TadAtThayer/ECG/Docs/ECG.png

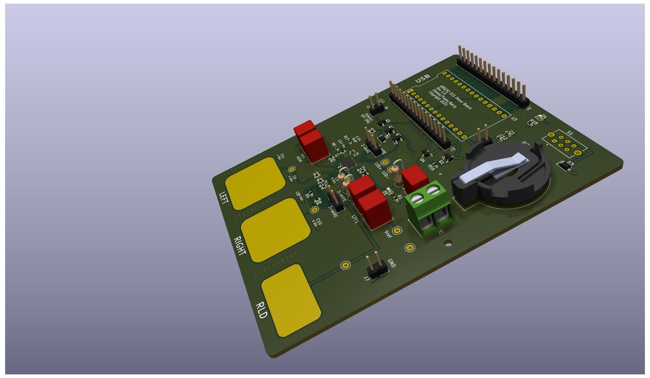
Docs/ECG.png
