TadAtThayer/ECG/README.md

# ECG

Prototype board for our online MENG program.

Utilizes an AD8232 Heart monitor AFE and has a supporting Arduino Nano 33 BLE.
