TadAtThayer/ECG/Docs/ECG_V1.0.pdf

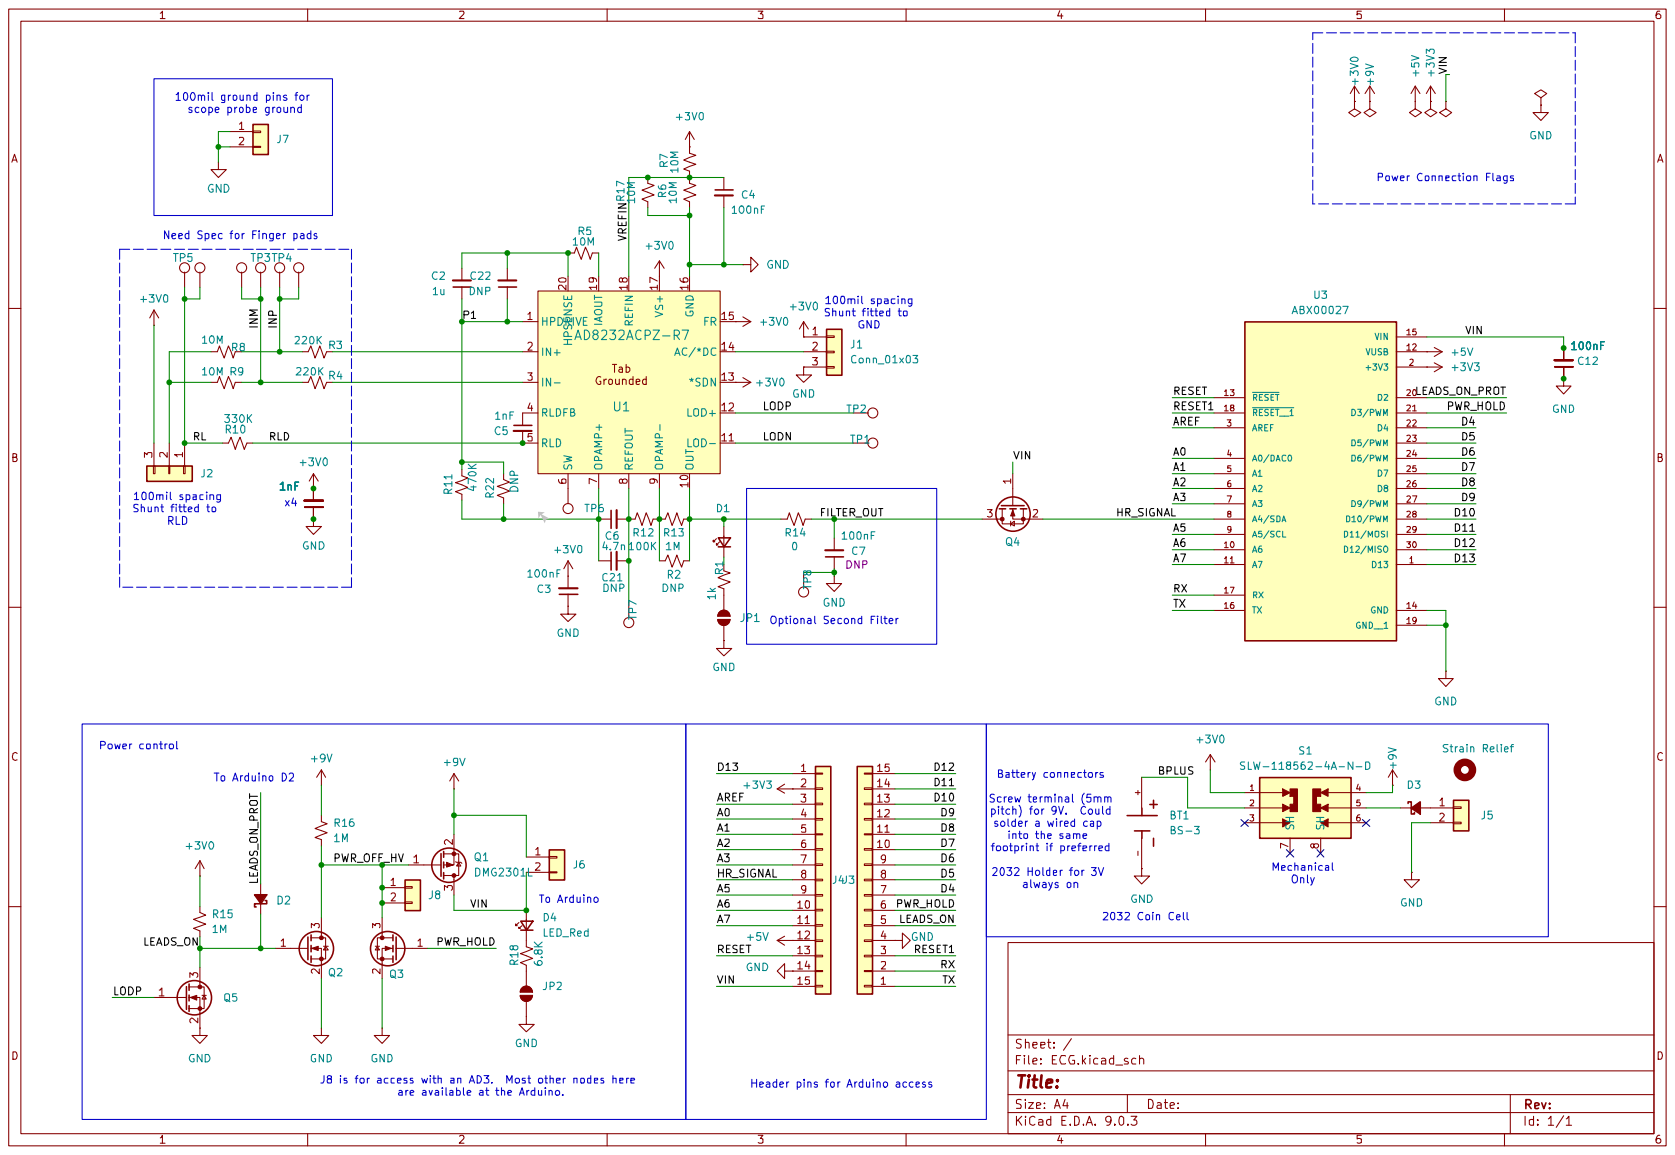
[picture p2: page 1]
