TadAtThayer/ECG/ECG/ECG.kicad_pcb

## KiCad design ECG/ECG.kicad_pcb (2026-07-17)

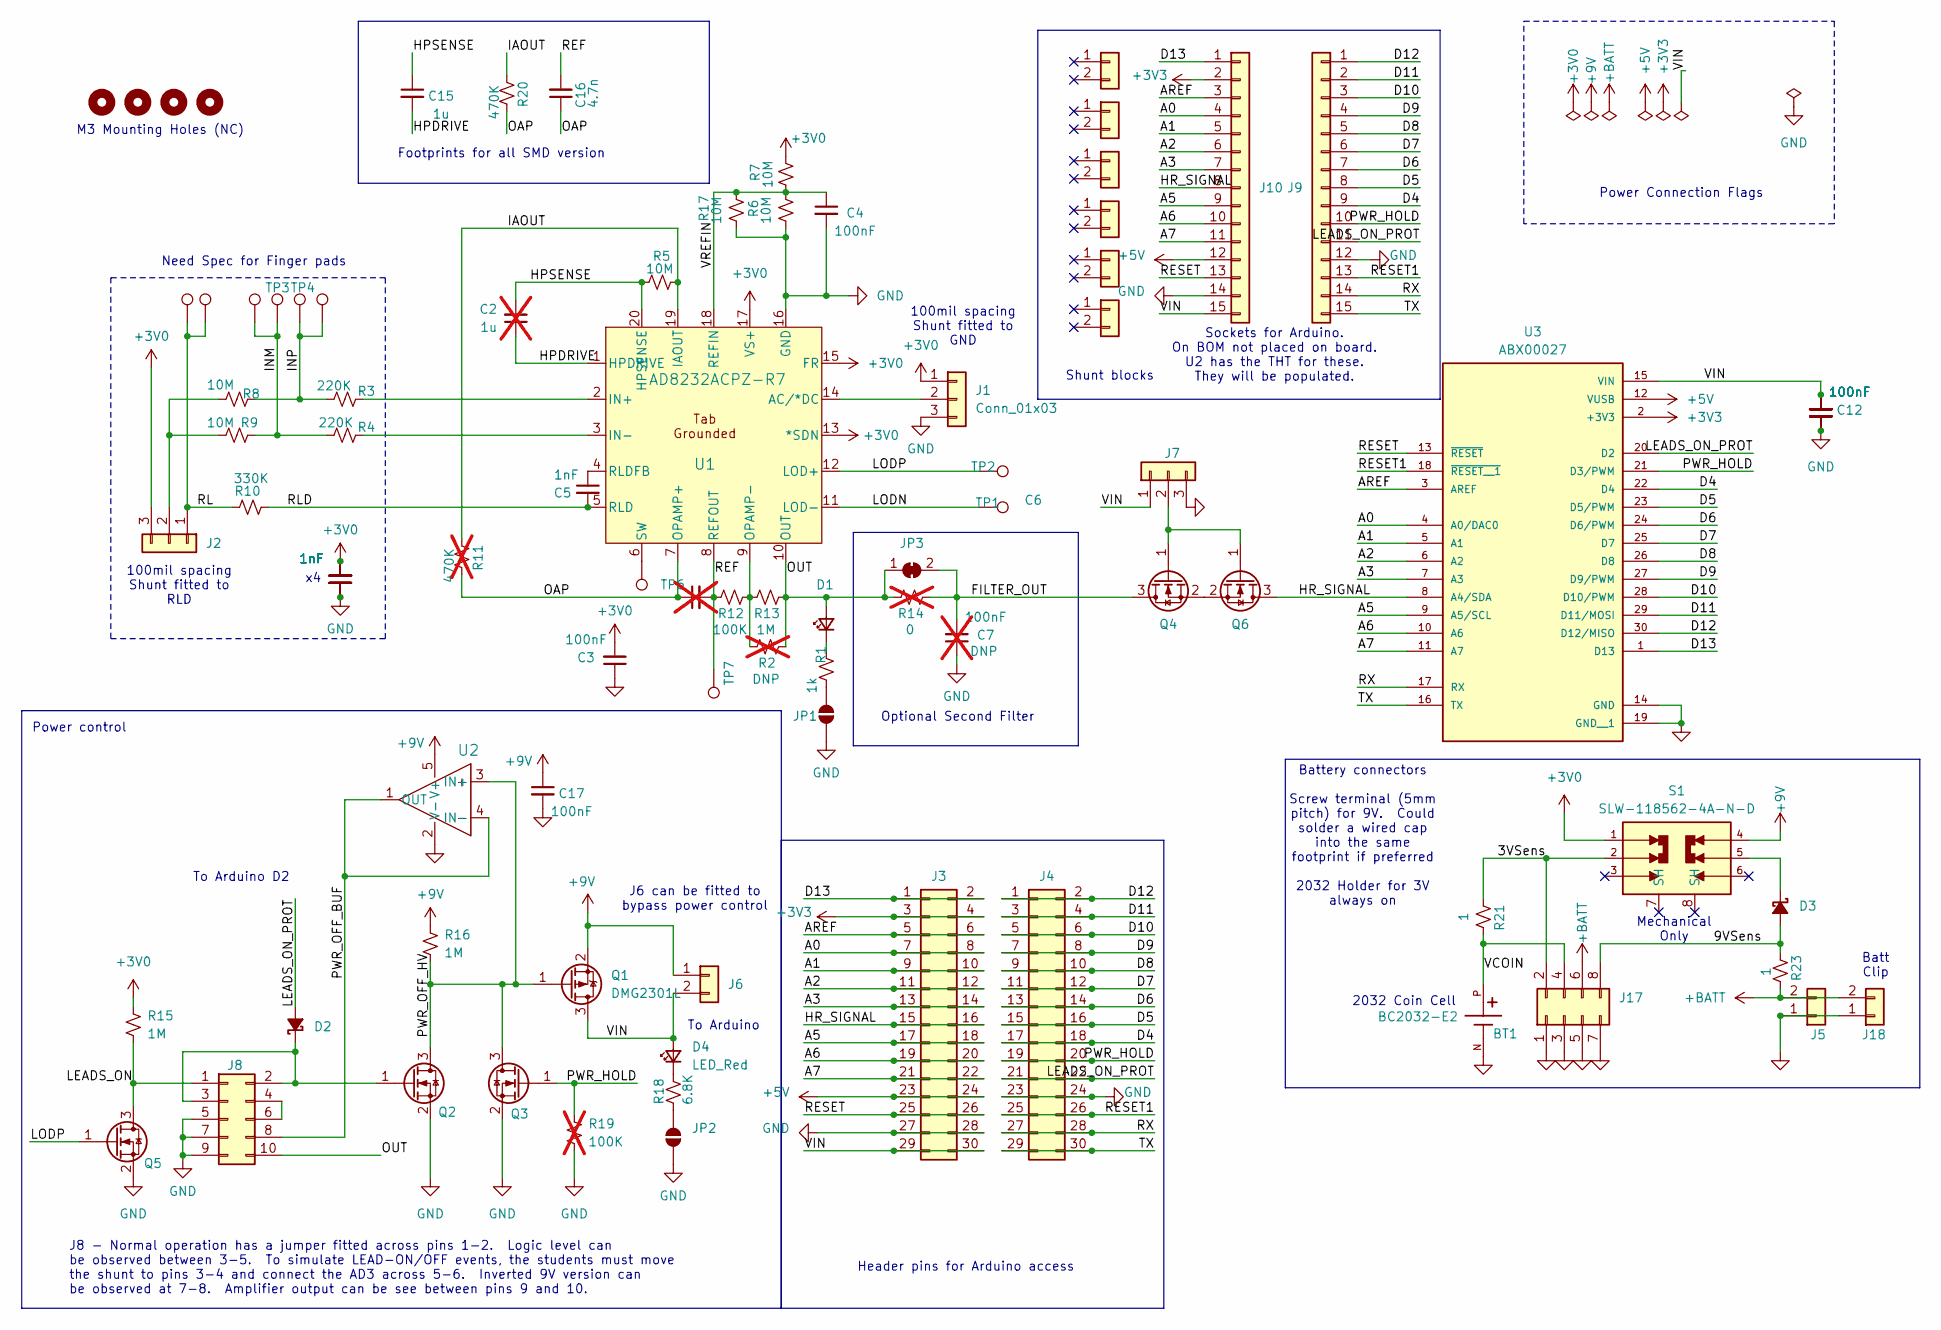
[picture p4: schematic ECG.kicad_sch]

Parts:
BT1: BC2032-E2; MPD_BC2032-E2; PARTREV D; DigikeyPN BC2032-E2-ND
C1, C3, C4, C12, C13, C14, C17: 100nF; C_0603_1608Metric; DigikeyPN 1276-1000-1-ND
C2: 1u; C_Rect_L7.2mm_W5.5mm_P5.00mm_FKS2_FKP2_MKS2_MKP2; DigikeyPN 399-5455-1-ND; not fitted
C5, C8, C9, C10, C11: 1nF; C_0603_1608Metric; DigikeyPN 1276-1018-1-ND
C6: 4.7n; C_Rect_L7.2mm_W5.5mm_P5.00mm_FKS2_FKP2_MKS2_MKP2; DigikeyPN 399-5905-ND; not fitted
C7: 100nF; C_Rect_L7.2mm_W5.5mm_P5.00mm_FKS2_FKP2_MKS2_MKP2; not fitted
C15: 1u; C_0603_1608Metric; DigikeyPN 311-2082-1-ND
C16: 4.7n; C_0603_1608Metric; Manufacturer_PN CL10B472KB8NNNC; DigikeyPN 1276-1098-1-ND
D1, D4: LED_Red; LED_0603_1608Metric; MPN 150060RS75000; DigikeyPN 732-4978-2-ND
D2, D3: D_SOD-123; DigikeyPN SM5817PL-TPMSCT-ND
H2, H3, H4, H5: MountingHole; MountingHole_3.2mm_M3
J1, J2, J7: Conn_01x03; PinHeader_1x03_P2.54mm_Vertical; DigikeyPN 732-5316-ND
J3, J4: Conn_02x15_Odd_Even; PinHeader_2x15_P2.54mm_Vertical; DigikeyPN 732-5306-ND
J5: Conn_01x02; 691137710002; DigikeyPN 732-10955-ND
J6: Conn_01x02; PinHeader_1x02_P2.54mm_Vertical; DigikeyPN 2057-PH1-02-UA-ND
J8: Conn_02x05_Odd_Even; PinHeader_2x05_P2.54mm_Vertical; DigikeyPN 2057-PH2-10-UA-ND
J9, J10: Socket 1x15; PinSocket_1x15_P2.54mm_Vertical; DigikeyPN PPPC151LFBN-RC
J11, J12, J13, J14, J15, J16: Shunt block; DigikeyPN S9341-ND
J17: Conn_02x04_Odd_Even; PinHeader_2x04_P2.54mm_Vertical; DigikeyPN 2057-PH2-08-UA-ND
J18: Conn_01x02; DigikeyPN 36-232-ND
JP1, JP2: SolderJumper_2_Open; SolderJumper-2_P1.3mm_Open_RoundedPad1.0x1.5mm
JP3: SolderJumper_2_Bridged; SolderJumper-2_P1.3mm_Bridged_RoundedPad1.0x1.5mm
Q1: DMG2301L; SOT-23; DigikeyPN DMG2301L-7DICT-ND
Q2, Q3, Q4, Q5, Q6: T2N7002AK; SOT-23; DigikeyPN T2N7002AKLMCT-ND
R1: 1k; R_0603_1608Metric; DigikeyPN 311-1.00KFRCT-ND
R2: DNP; R_0603_1608Metric; DigikeyPN RMCF0603FT1M00CT-ND; not fitted
R3, R4: 220K; R_0603_1608Metric; DigikeyPN RMCF0603FT220KCT-ND
R5, R6, R7, R8, R9, R17: 10M; R_0603_1608Metric; DigikeyPN 311-10.0MHRCT-ND
R10: 330K; R_0603_1608Metric; DigikeyPN RMCF0603FT330KCT-ND
R11: 470K; R_Axial_DIN0207_L6.3mm_D2.5mm_P2.54mm_Vertical; DigikeyPN 13-MFR-25FTE52-470KCT-ND; not fitted
R12: 100K; R_0603_1608Metric; DigikeyPN RMCF0603FT100KCT-ND
R13, R15, R16: 1M; R_0603_1608Metric; DigikeyPN 311-1.0MGRCT-ND
R14: 0; R_Axial_DIN0207_L6.3mm_D2.5mm_P2.54mm_Vertical; not fitted
R18: 6.8K; R_0603_1608Metric; DigikeyPN RMCF0603FT6K80CT-ND
R19: 100K; R_0603_1608Metric; DigikeyPN RMCF0603FT1M00CT-ND; not fitted
R20: 470K; R_0603_1608Metric; DigikeyPN RMCF0603FT470KCT-ND
R21, R23: 1; R_0603_1608Metric; DigikeyPN 13-RT0603BRD071RLCT-ND
S1: SLW-118562-4A-N-D; SW_SLW-118562-4A-N-D; PARTREV 1.01; DigikeyPN 2223-SLW-118562-4A-N-D-ND
TP1, TP2, TP3, TP4, TP5, TP6, TP7: TestPoint; TestPoint_Keystone_5000-5004_Miniature
TP9: TestPoint; RefPad
TP10, TP11: TestPoint; FingerPad
U1: AD8232ACPZ-R7; CP_20_10_ADI_NOTH; DigikeyPN 505-AD8232ACPZ-R7CT-ND
U2: OPA237NA/3K; SOT-23-5; DigiKeyPN 296-26265-1-ND
U3: ABX00027; DIP30-ArduinoNano

Connections:
+3V0: C3.2, C8.2, C9.2, C10.2, C11.2, J1.1, J2.3, R7.1, R15.1, S1.1, U1.13 (*SDN), U1.15 (FR), U1.17 (VS+)
+3V3: J3.3, J3.4, J10.2, U3.2 (+3V3)
+5V: J3.23, J3.24, J10.12, U3.12 (VUSB)
+9V: C17.1, J6.1, Q1.2 (S), R16.1, S1.4, U2.5 (V+)
+BATT: J5.2, J17.6, J18.2, R23.2
/3VSens: J17.2, R21.1, S1.2
/9VSens: D3.2 (A), J17.8, R23.1
/A0: J3.7, J3.8, J10.4, U3.4 (A0/DAC0)
/A1: J3.9, J3.10, J10.5, U3.5 (A1)
/A2: J3.11, J3.12, J10.6, U3.6 (A2)
/A3: J3.13, J3.14, J10.7, U3.7 (A3)
/A5: J3.17, J3.18, J10.9, U3.9 (A5/SCL)
/A6: J3.19, J3.20, J10.10, U3.10 (A6)
/A7: J3.21, J3.22, J10.11, U3.11 (A7)
/AREF: J3.5, J3.6, J10.3, U3.3 (AREF)
/D4: J4.17, J4.18, J9.9, U3.22 (D4)
/D5: J4.15, J4.16, J9.8, U3.23 (D5/PWM)
/D6: J4.13, J4.14, J9.7, U3.24 (D6/PWM)
/D7: J4.11, J4.12, J9.6, U3.25 (D7)
/D8: J4.9, J4.10, J9.5, U3.26 (D8)
/D9: J4.7, J4.8, J9.4, U3.27 (D9/PWM)
/D10: J4.5, J4.6, J9.3, U3.28 (D10/PWM)
/D11: J4.3, J4.4, J9.2, U3.29 (D11/MOSI)
/D12: J4.1, J4.2, J9.1, U3.30 (D12/MISO)
/D13: J3.1, J3.2, J10.1, U3.1 (D13)
/FILTER_OUT: C7.2, JP3.2 (B), Q4.3 (D), R14.2
/HPDRIVE: C2.1, C15.2, U1.1 (HPDRIVE)
/HPSENSE: C2.2, C15.1, R5.2, U1.20 (HPSENSE)
/HR_SIGNAL: J3.15, J3.16, J10.8, Q6.3 (D), U3.8 (A4/SDA)
/IAOUT: R5.1, R11.2, R20.2, U1.19 (IAOUT)
/INM: R4.1, R9.2, TP3.1, TP10.1
/INP: R3.1, R8.1, TP4.1, TP11.1
/LEADS_ON: J8.1, Q5.3 (D), R15.2
/LEADS_ON_PROT: D2.2 (A), J4.21, J4.22, J9.11, U3.20 (D2)
/LODN: TP1.1, U1.11 (LOD-)
/LODP: Q5.1 (G), TP2.1, U1.12 (LOD+)
/OAP: C6.1, C16.1, R11.1, R20.1, U1.7 (OPAMP+)
/OUT: D1.2 (A), J8.10, JP3.1 (A), R2.2, R13.2, R14.1, U1.10 (OUT)
/PWR_HOLD: J4.19, J4.20, J9.10, Q3.1 (G), R19.1, U3.21 (D3/PWM)
/PWR_OFF_BUF: J8.8, U2.1 (OUT), U2.4 (IN-)
/PWR_OFF_HV: Q1.1 (G), Q2.3 (D), Q3.3 (D), R16.2, U2.3 (IN+)
/REF: C6.2, C16.2, R12.1, TP7.1, U1.8 (REFOUT)
/RESET: J3.25, J3.26, J10.13, U3.13 (~RESET)
/RESET1: J4.25, J4.26, J9.13, U3.18 (~RESET__1)
/RL: J2.1, R10.1, TP5.1, TP9.1
/RLD: C5.2, R10.2, U1.5 (RLD)
/RX: J4.27, J4.28, J9.14, U3.17 (RX)
/TX: J4.29, J4.30, J9.15, U3.16 (TX)
/VCOIN: BT1.P, J17.4, R21.2
/VIN: C1.2, C12.2, C13.2, C14.2, D4.2 (A), J3.29, J3.30, J6.2, J7.1, J10.15, Q1.3 (D), U3.15 (VIN)
/VREFIN: C4.1, R6.1, R7.2, R17.1, U1.18 (REFIN)
GND: BT1.N, C1.1, C3.1, C4.2, C7.1, C8.1, C9.1, C10.1, C11.1, C12.1, C13.1, C14.1, C17.2, J1.3, J3.27, J3.28, J4.23, J4.24, J5.1, J7.3, J8.5, J8.7, J8.9, J9.12, J10.14, J17.1, J17.3, J17.5, J17.7, J18.1, JP1.1 (A), JP2.1 (A), Q2.2 (S), Q3.2 (S), Q5.2 (S), R6.2, R17.2, R19.2, U1.16 (GND), U2.2 (V-), U3.14 (GND), U3.19 (GND__1)
unnamed: D1.1 (K), R1.1
unnamed: D2.1 (K), J8.2, J8.3, Q2.1 (G)
unnamed: D3.1 (K), S1.5
unnamed: D4.1 (K), R18.1
unnamed: J1.2, U1.14 (AC/*DC)
unnamed: J2.2, R8.2, R9.1
unnamed: J7.2, Q4.1 (G), Q6.1 (G)
unnamed: J8.4, J8.6
unnamed: JP1.2 (B), R1.2
unnamed: JP2.2 (B), R18.2
unnamed: Q4.2 (S), Q6.2 (S)
unnamed: R3.2, U1.2 (IN+)
unnamed: R4.2, U1.3 (IN-)
unnamed: R2.1, R12.2, R13.1, U1.9 (OPAMP-)
unnamed: C5.1, U1.4 (RLDFB)
unnamed: TP6.1, U1.6 (SW)

Notes on the sheet:
To Arduino
Header pins for Arduino access
Footprints for all SMD version
To Arduino D2
100mil spacing Shunt fitted to RLD
2032 Coin Cell
Battery connectors Screw terminal (5mm pitch) for 9V. Could solder a wired cap into the same footprint if preferred 2032 Holder for 3V always on
J8 - Normal operation has a jumper fitted across pins 1-2. Logic level can be observed between 3-5. To simulate LEAD-ON/OFF events, the students must move the shunt to pins 3-4 and connect the AD3 across 5-6. Inverted 9V version can be observed at 7-8. Amplifier output can be see between pins 9 and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
100mil spacing Shunt fitted to GND
Mechanical Only
J6 can be fitted to bypass power control
Sockets for Arduino. On BOM not placed on board. U2 has the THT for these. They will be populated.
Power Connection Flags
Shunt blocks
Optional Second Filter
Power control
Batt Clip
M3 Mounting Holes (NC)
Need Spec for Finger pads

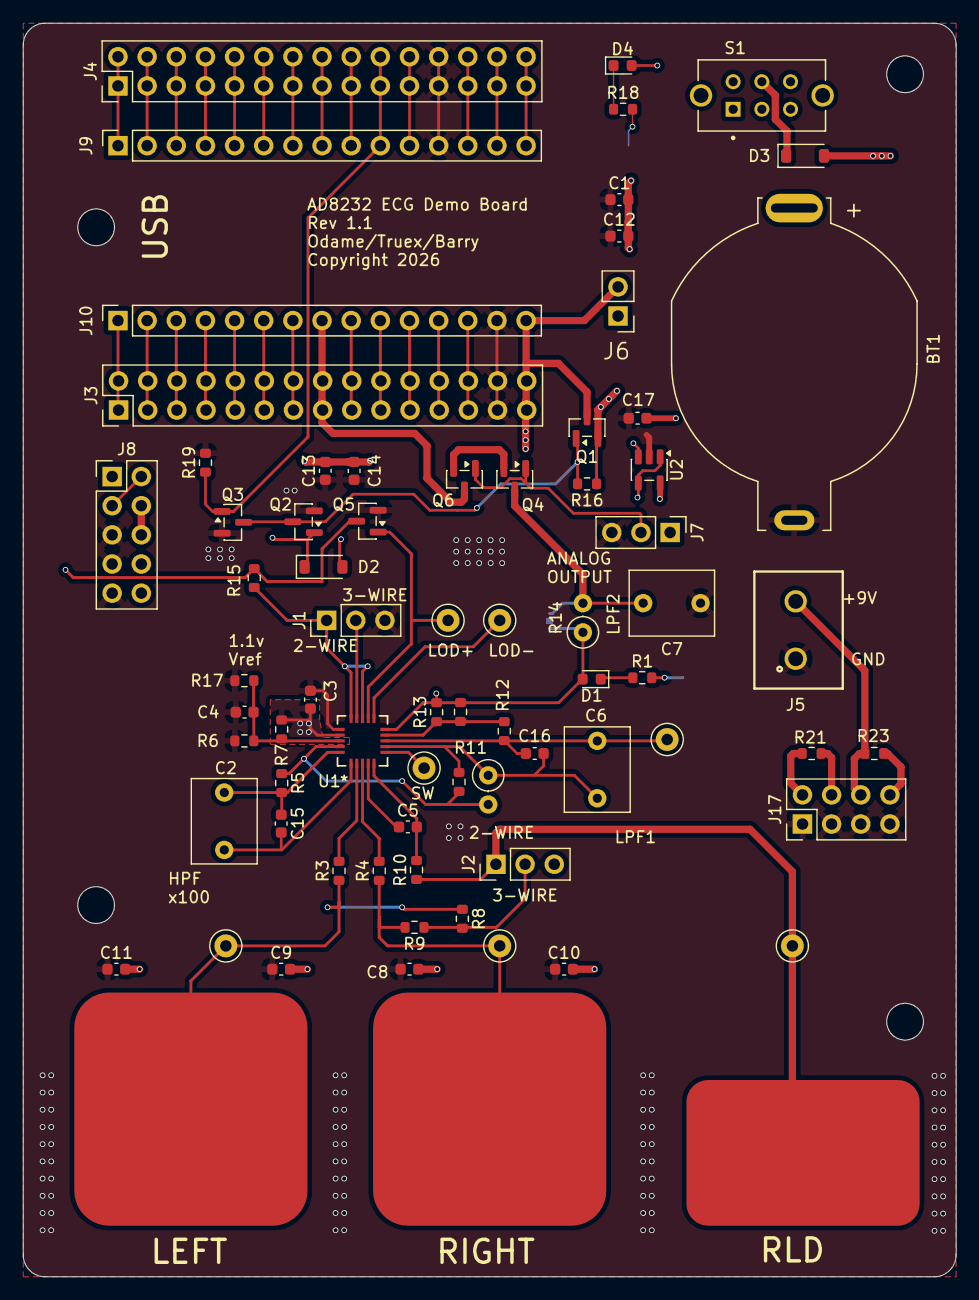
[picture p5: board ECG.kicad_pcb from above]

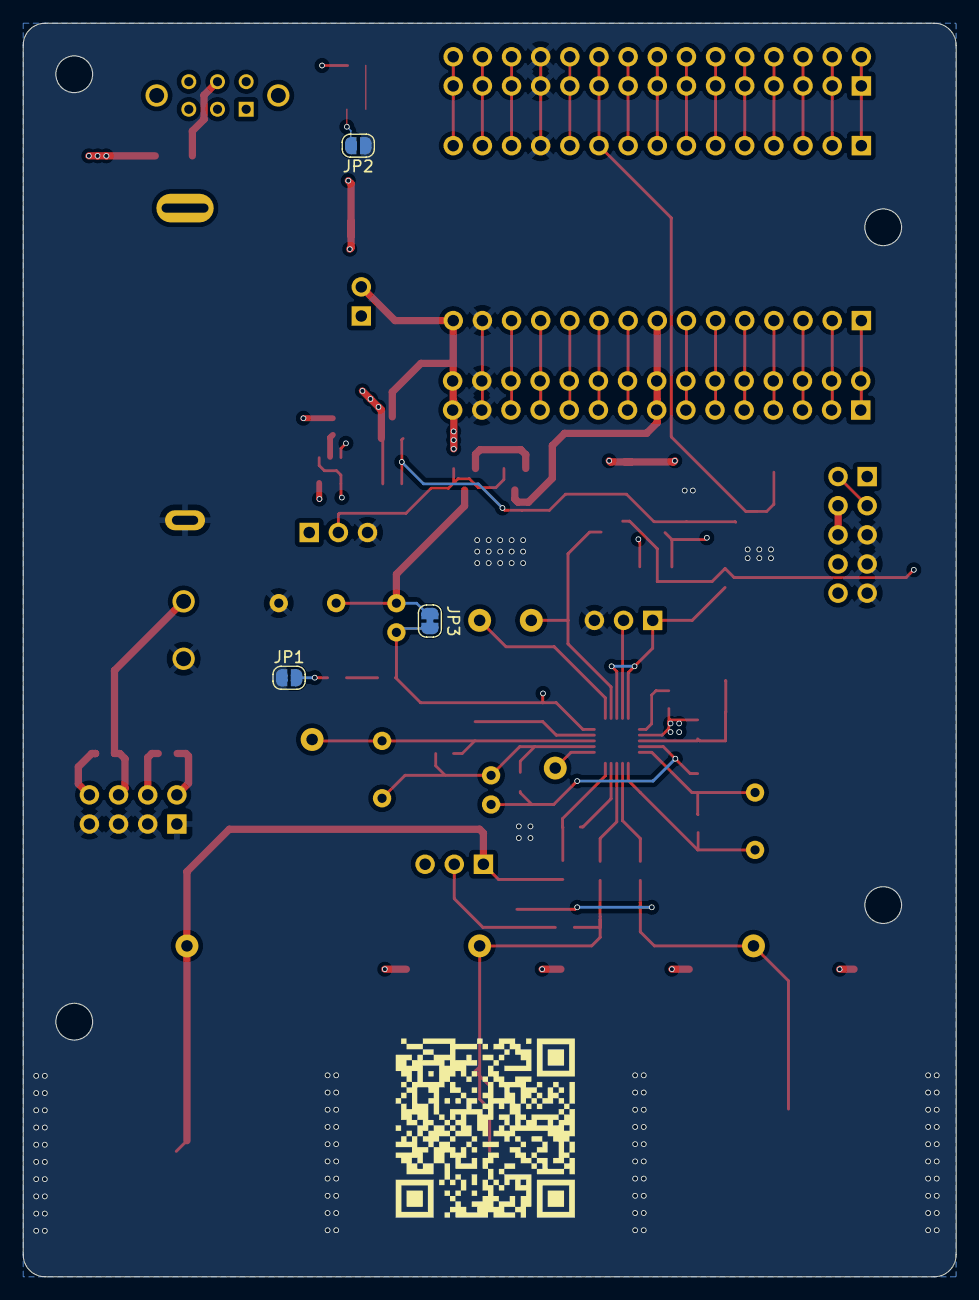
[picture p6: board ECG.kicad_pcb from below]

Board: 4 copper layers, 81.3 x 109.2 mm, 81 parts (3 on the bottom side), 68 nets.
