TadAtThayer/ECG/(threads)

Thread 1 (2025-07-22):

Bootstrap power to Arduino

tadtruex, 2025-07-22:
As currently conceived, the Arduino power switch will never turn on.

Possible solutions:

1. Add a coin battery to power the monitor.  Kofi is in favor of this.
2. Always power the Arduino and use the power down features to reduce the draw of the uP when not in use.
3. Leave the power system as is (modulo the stuff in #2 ) but add a second buck converter to power the heart rate monitor.

Closed 2025-07-25.

Thread 6 (2025-08-14):

IAOUT incorrectly connected.

tadtruex, 2025-08-14:
IAOUT (Pin 19) needs to be connected to R11.

R11 needs to be disconnected from Pin 1.

ECO - Cut trace from C2 to the via near Pin 1.  Green wire from R11 to R7.

Closed 2025-08-14.

Thread 8 (2025-08-15):

Transistor Switches not working

tadtruex, 2025-08-15:
Not obvious that the transistor switches are working very well.  Need to investigate before next spin
