TadAtThayer/ECG/(commit log)

2025-07-21 Add skeleton Kicad Proj
    Add a few words in the readme.
    [ECG.kicad_pcb, ECG.kicad_sch]
2025-07-21 start collecting footprints and docs
    [ECG.kicad_pcb, ECG.kicad_sch]
2025-07-22 WIP - Bobs V1 more or less captured.
    [ECG.kicad_sch]
2025-07-23 use NO4 as inverter
    [ECG.kicad_sch]
2025-07-23 begin assigning footprints
    [ECG.kicad_sch]
2025-07-23 first pass transistor based power control
    [ECG.kicad_pcb, ECG.kicad_sch]
2025-07-24 add battery connections and start playing with placement
    [ECG.kicad_pcb]
2025-07-24 WIP Transitor Switches
    Work on transistor placement
    [ECG.kicad_pcb]
2025-07-24 tinkering with switching logic placements
    [ECG.kicad_pcb, ECG.kicad_sch]
2025-07-24 WIP
    first edits
    [ECG.kicad_sch]
2025-07-24 WIP2
    new positions
    [ECG.kicad_pcb, ECG.kicad_sch]
2025-07-25 WIPmorning1
    switch added
    [ECG.kicad_pcb, ECG.kicad_sch]
2025-07-25 WIPmorn2
    SBD
    [ECG.kicad_sch]
2025-07-25 R22
    want layout update
    [ECG.kicad_sch]
2025-07-25 Vref?
    Vref layout wrong
    [ECG.kicad_pcb]
2025-07-25 Done for Friday
    See you Monday. Parts connected and snugged up.
    [ECG.kicad_pcb, ECG.kicad_sch]
2025-07-28 Vref, add TPs
    Added R17, TP7, TP8
    [ECG.kicad_pcb, ECG.kicad_sch]
2025-07-28 Labels
    Added all labels
    [ECG.kicad_pcb]
2025-07-29 start cleanup
    [ECG.kicad_pcb]
2025-07-30 WIP:
    1) Cleanup macro placement a bit to reduce board cost.
    2) Start final routing and plane additions
    3) Clean up drcs.
    [ECG.kicad_pcb, ECG.kicad_sch]
2025-07-30 DRC and ERC clean.
    Decent layout.
    Silk needs work.
    [ECG.kicad_pcb, ECG.kicad_sch]
2025-07-30 V1.0 candidate
    [ECG.kicad_pcb]
2025-07-31 getting close. Larger vias for cheaper process
    [ECG.kicad_pcb, ECG.kicad_sch]
2025-07-31 Edits from review with Kofi
    [ECG.kicad_pcb, ECG.kicad_sch]
2025-07-31 Add strain relief
    [ECG.kicad_pcb, ECG.kicad_sch]
2025-08-01 final tweaks for v1.0
    Add protection diode for Arduino D2
    Add some silk
    [ECG-B_Cu.gbr, ECG-B_Mask.gbr, ECG-B_Paste.gbr, ECG-B_Silkscreen.gbr, ECG-Edge_Cuts.gbr, ECG-F_Cu.gbr, ECG-F_Mask.gbr, ECG-F_Paste.gbr]
2025-08-01 fix qrcode
    [ECG-B_Cu.gbr, ECG-B_Mask.gbr, ECG-B_Paste.gbr, ECG-B_Silkscreen.gbr, ECG-Edge_Cuts.gbr, ECG-F_Cu.gbr, ECG-F_Mask.gbr, ECG-F_Paste.gbr]
2025-08-01 Fix +9V Label
    [ECG-B_Cu.gbr, ECG-B_Mask.gbr, ECG-B_Paste.gbr, ECG-B_Silkscreen.gbr, ECG-Edge_Cuts.gbr, ECG-F_Cu.gbr, ECG-F_Mask.gbr, ECG-F_Paste.gbr]
2025-08-01 Work on BOM
    [ECG.kicad_sch]
2025-08-05 BOM updates.
    [ECG.csv, ECG.kicad_pcb, ECG.kicad_sch]
2025-08-08 Start cleaning up fab layers for build
    [ECG.kicad_pcb]
2025-08-14 Connect IAOUT to R11. Disconnect Disconnect Pin 1 from R11
    Fixes #6
    [ECG.kicad_pcb, ECG.kicad_sch]
2025-08-27 officially DNP one of the otional caps
    [ECG.kicad_pcb, ECG.kicad_sch]
2025-09-08 Add some mounting holes
    Close #3
    [ECG.kicad_pcb, ECG.kicad_sch]
2025-09-08 silkscreen cleanup
    [ECG.kicad_pcb]
2025-09-08 Remove thermal pad and pin from ADI HRM chip. Doesn't provide any obvious benefit and make manual assembly very difficult.
    Close #9
    [ECG.kicad_pcb, ECG.kicad_sch]
2025-09-08 add some SMD footprint for SMD only version
    Close #10
    [ECG.kicad_pcb, ECG.kicad_sch]
2025-09-08 Update rev number and logo
    Close #11
    [ECG.kicad_pcb]
2025-09-08 gerbers for v1.0b
    [ECG-B_Cu.gbr, ECG-B_Mask.gbr, ECG-B_Paste.gbr, ECG-B_Silkscreen.gbr, ECG-Edge_Cuts.gbr, ECG-F_Cu.gbr, ECG-F_Mask.gbr, ECG-F_Paste.gbr]
2025-12-11 Register some ECOs on the schematic.
    Implementation still TBD
    [ECG.kicad_sch]
2025-12-16 Change coin cell holder to one the is dummy "proof"
    Close #14
    [ECG.kicad_pcb, ECG.kicad_sch]
2025-12-16 Add control of LeadsOn from AD3
    Close #16
    [ECG.kicad_pcb, ECG.kicad_sch]
2025-12-22 new diode footprint
2026-01-09 Work on AD3 connection stuff
    [ECG.kicad_pcb, ECG.kicad_sch]
2026-01-12 Manually merge commit d0bb662.
    Low leakage schottky for protection.
    [ECG.kicad_pcb, ECG.kicad_sch]
2026-01-12 cleanup layout
    [ECG.kicad_pcb, ECG.kicad_sch]
2026-01-12 Cleanup layout.
    Close #17
    Close #15
    [ECG.kicad_pcb, ECG.kicad_sch]
2026-01-12 update qr code
    [ECG.kicad_pcb]
2026-01-12 work on manufacturing
    [ECG-B_Cu.gbr, ECG-B_Mask.gbr, ECG-B_Paste.gbr, ECG-B_Silkscreen.gbr, ECG-Edge_Cuts.gbr, ECG-F_Cu.gbr, ECG-F_Mask.gbr, ECG-F_Paste.gbr]
2026-01-16 Remove paste from finger pads.
    new gerbers
    [ECG-B_Cu.gbr, ECG-B_Mask.gbr, ECG-B_Paste.gbr, ECG-B_Silkscreen.gbr, ECG-Edge_Cuts.gbr, ECG-F_Cu.gbr, ECG-F_Mask.gbr, ECG-F_Paste.gbr]
2026-01-16 Update bom and placement files for manufacturing
    Changes to be committed:
    modified: ECG-top-pos.csv
    modified: ECG.csv
    modified: ECG_bom.csv
    [ECG.csv, ECG_bom.csv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]
2026-01-27 wip bom
    [ECG_thd.csv]
2026-01-27 annotations for manual thd comps
    [ECG.kicad_sch, ECG_thd.csv]
2026-06-03 Replace 3 THD comps with the SMD versions in the callout box.
    Remove old revision tracker.
    Fix latent overlapping silkscreen error.
    [ECG.kicad_pcb, ECG.kicad_sch]
2026-06-17 Add J7 and Q6.
    J7 allows the students to turn off the path to the output of the 8232.
    Q6 provides a second reversed body diode on the path to prevent
    current flow when the path is blocked via the jumper and the
    students force a voltage onto A4.
    Close #20.
    [ECG.kicad_sch]
2026-06-17 Add a connector for testing supply voltages.
    Close #27
    Close #28
    [ECG.kicad_sch]
2026-06-18 add R21 and R23 for current measurement
    [ECG.kicad_sch]
2026-06-18 Add 1 ohm resistors to both supplies for current measurement (R21 R23).
    Update J17 to provide test points for both.
    Close #23
    Close #24
    [ECG.kicad_sch]
2026-06-23 Add double row header pins for Arduino. BOM not yet updated.
    Close #26
    [ECG.kicad_sch]
2026-06-23 Add op amp buffer to pwr_off_hv to allow monitoring with the relatively low input impedance of the AD3
    Work on #25
    Probably need to look for a CMOS op-amp. This one pulls
    600nA input bias which will likely turn on the pfet and
    power up the nano all the time...
    [ECG.kicad_sch]
2026-06-29 Start looking at footprints and placements.
    [ECG.kicad_pcb, ECG.kicad_sch]
2026-07-06 add rogue thd bom section from original design
2026-07-06 Replace high leakage op-amp with slower low power variant to minimize input current requirements.
    Close #25
    [ECG.kicad_pcb, ECG.kicad_sch]
2026-07-06 remove some redundant(er) THD footprints
    [ECG.kicad_sch]
2026-07-06 First shot at P&R for these edits.
    [ECG.kicad_pcb]
2026-07-08 add socket for arduino into bom. exclude arduino from board.
    Add decap for new op-amp.
    Close #39
    [ECG.kicad_pcb, ECG.kicad_sch]
2026-07-14 Add new QR code.
    Close #32
    [ECG.kicad_pcb]
2026-07-14 v1.1 gerbers
    [ECG-B_Cu.gbr, ECG-B_Mask.gbr, ECG-B_Paste.gbr, ECG-B_Silkscreen.gbr, ECG-Edge_Cuts.gbr, ECG-F_Cu.gbr, ECG-F_Mask.gbr, ECG-F_Paste.gbr]
2026-07-14 part numbers for the pins
    [ECG.kicad_sch]
2026-07-14 add bom only part to hold 9V battery connector
    [ECG.kicad_sch]
2026-07-15 update some part numbers
    [ECG.kicad_sch]
2026-07-15 A number of part modification to make JLCPCBs inventory.
    Rework voltage follower to match new op-amp.
    Generate new gerbers and drills.
    [ECG-B_Cu.gbr, ECG-B_Mask.gbr, ECG-B_Paste.gbr, ECG-B_Silkscreen.gbr, ECG-Edge_Cuts.gbr, ECG-F_Cu.gbr, ECG-F_Mask.gbr, ECG-F_Paste.gbr]
2026-07-15 add some LCSC specifics
    [ECG.kicad_sch]
2026-07-15 work on position file.
    [ECG_bom.csv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]
2026-07-16 Rework the sense resistor on the 9V battery.
    Move sense to high side.
    Also move 9V measure to battery terminal, move from down stream
    of switch.
    [ECG.kicad_sch]
2026-07-17 Move sense resistors to high side.
    Move Battery measurement points upstream of switch.
    Remove superfluous strain relief
    Bolster high side power connection.
    GND flood on IN2
    Update copyright.
    Close #42
    Close #43
    [ECG-B_Cu.gbr, ECG-B_Mask.gbr, ECG-B_Paste.gbr, ECG-B_Silkscreen.gbr, ECG-Edge_Cuts.gbr, ECG-F_Cu.gbr, ECG-F_Mask.gbr, ECG-F_Paste.gbr]
2026-07-17 updated cpl
    [ECG_cpl.csv]
2026-07-21 remove some stale files
    [ECG.csv, ECG_thd.csv, bom_filled.csv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]
2026-07-21 add leds back for debug/bringup, remove junk from zip
    [ECG.kicad_sch, ECG_bom.csv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]
2026-07-21 update cpl with rotations
    [ECG_cpl.csv]
2026-07-22 fix hrm orientation
    [ECG_cpl.csv]
2026-07-22 auto updated LCSC and MPN part numbers
    [ECG.kicad_sch]
2026-07-22 fix BOM to replace 1206 R1 with 0603 R1.
    [ECG.kicad_sch, ECG_bom.csv]
