TadAtThayer/ECG/(notices)

Notices in the files:
ECG/ECG.kicad_pcb:
Copyright 2026
